ucb-bar/atlas-npu/(commit log)

2026-02-10 rename build.mill to not me recognized by chipyard build
2026-02-13 FIX: remove duplicated mill executable
2026-02-13 FIX: move mill to root for BSP to work
2026-04-01 feat: top-level integration of DMA, IMEM, ScalarCore, Frontend, LSU, TRF, MXU0, Instruction Decode
2026-04-06 Dma sbus
2026-04-07 MXU Integration, Hazard/Stalling Logic, XLU Optimization, & Codebase Refactor
    [converters.h, converters.py, fp_formats.h, fp_formats.py]
2026-04-08 Make MXU Mill Tests Compliant with CI/CD & software-scheduled design
2026-04-09 baremetal testing framework
2026-04-09 remove deprecated assembly files
2026-04-16 Updated VPU Integration, Banked VMEM (LSU and DMA Updates), More Comprehensive Baremetal Testing
2026-04-24 revert assembler
2026-04-29 Dma params
2026-04-29 fix: dma store queue size
2026-05-05 Dma config update
2026-05-07 Replace run_asm_tests.sh with Makefile-driven test flow
2026-10-08 Initial perf counters addition (MXU, VPU, DMA, ScalarCore, and per-bank VMEM/MREG counters)
2026-10-16 Assemble Atlas baremetal tests with npu_model (#2)
    * chore(deps): bump npu-model to the merged assembler
    * refactor(baremetal): assemble with npu_model and retire the legacy assembler
2026-10-22 Interlock structural and data hazards in the scalar core
    The instruction in S1 now stalls until it can issue without a hazard,
    so programs no longer need DELAY spacing (DELAY stays legal).
    - MXU sequencers export cmdReady (their accept condition for the
    decoded command) and also wait on the weight/accumulator push paths
    and the 1R1W accumulator ports, which were only asserted before.
    - MXUs report a mreg port to the tracker only while it will still
    access its bank, so same-register back-to-back commands keep a
    32-cycle stride.
    - LSU reports the VMEM bank of each vector path; DmaEngine reports
    whether its next command slot is free.
    - ScalarCore stalls on unit readiness (MXU, VPU, X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
2026-10-22 Add a standalone, host-driven VCU118 build
    A host replaces the CPU over UART TSI (PyUARTSI protocol): it loads the
    kernel into IMEM and data into DRAM, starts the core through
    EXEC_CONTROL, polls DBG0 and reads the results, as the Chipyard C
    harness does. No Chipyard or rocket-chip at build time.
    - standalone/chisel: EmitAtlasCore writes AtlasCore with fixed TL-UL
    ports; tilelink/ stands in for TLBundle, TLBundleParameters and
    TLMessages (channels A and D), the only rocket-chip types it uses.
    - standalone/rtl: UART TSI target and TL-UL fabric from NVFP4, adapters
    to AtlasCore's TileLink ports, 4 MiB UltraRAM DRAM (host + DMA ports),
    system registers, VCU118 top.
    - standalone/sim: Ve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
2026-10-22 standalone: run-cycle counter, UART TSI co-simulation, PyUARTSI pin
    - sys_regs RUN_CYCLES counts cycles while the scalar core runs, so the
    host reads exact kernel time over the slow TSI link.
    - MODEL=tsi builds a Verilator model of atlas_tsi_soc driven through its
    UART pins by PyUARTSI (run_tests.py --tsi-sim).
    - host/requirements.txt pins pyuartsi to the commit NVFP4 uses (the
    PyPI release lacks the transport argument).
    - build_bitstream.sh emits Verilog into the output directory.
    Claude-Session: https://claude.ai/code/session_01F6q9eNx8CF3r7uDR1jy24c
2026-10-22 standalone: board results, TSI read retry, program.tcl DONE check
    The bitstream runs all 121 baremetal tests on the VCU118 over UART TSI,
    with and without DELAY, at the simulation's cycle counts.
    - TsiLink reads a chunk again when its reply lost a byte (about one
    byte per 2.8 MB suite at 921,600 baud); reads are idempotent.
    - program.tcl reads DONE from REGISTER.IR (the 7-series status bit does
    not exist on UltraScale+).
    - README records the build, the results, and why jal_jalr reports PASS
    on the board while failing its first subtest (stale x11, and a fail
    code equal to the pass code).
    Claude-Session: https://claude.ai/code/s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
2026-10-22 Add ipt and ipt-nvfp4 configurations with an NVFP4 MXU
    AtlasConfigs names three configurations: default (systolic array +
    inner-product trees), ipt (inner-product trees only) and ipt-nvfp4
    (inner-product trees + an NVFP4 MXU in the systolic array's slot).
    Instructions for an absent unit are illegal.
    NVFP4 MXU (docs/nvfp4-mxu.md):
    - 32 fp4_fedp lanes from the NVFP4 repo (BlackBox resources in
    src/main/resources/vsrc/nvfp4; block sums from
    sashakatne/nvfp4-dotprod-formal-dv, Apache-2.0): acc = A @ W^T over
    64 NVFP4 elements per row, FP32 accumulators, NVIDIA m16n8k64
    arithmetic; one matmul per 32 cycles.
    - Per-register scale sidecar (MregScaleFile, 32 rows x 4 UE4M3 bytes)
    loaded an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
2026-10-22 standalone: board results for the ipt and ipt-nvfp4 configurations
    Both bitstreams meet timing at 50 MHz and run the 126-test suite on the
    VCU118 as expected, with and without DELAY: ipt 93 pass / 33 illegal,
    ipt-nvfp4 98 pass / 28 illegal, the 5 NVFP4 tests bit-exact against the
    reference model. program.tcl reads DONE from REGISTER.IR.BIT05_DONE, the
    property's name in Vivado 2024.2.
    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
2026-10-23 test(nvfp4): check the model and fp4_fedp against stored silicon vectors
    10k-vector subsets of ucb-bar/nvfp4@0c611e1's RTX 5090 / Jetson Thor NVFP4
    results. Model and RTL both match on 39,999 / 40,000; the miss is the
    all-zero 16-element block, now named as the one known gap wherever the
    docs claim bit-exactness. Sources are cited by commit, not by local path.
    Claude-Session: https://claude.ai/code/session_01Lv3Wtz6DrusWeiooX31Zcj
